eerdemgundogdu/acoustic-underwater-drone_swarm/hardware/output/acoustic-swarm-node-revA-bom.csv

Adet | Referanslar | Deger | Footprint | Parca | Not
2 | C1 C38 | 47uF 35V | CP_Elec_6.3x7.7 | Panasonic EEE-FK1V470P | H-koprusu VM toplu kapasite; Toplu giris kondansatoru
3 | C2 C3 C40 | 2.2uF 50V | C_1210_3225Metric | X7R 1210 50V
8 | C4 C12 C16 C18 C19 C32 C35 C41 | 100nF | C_0603_1608Metric | X7R 0603 16V
1 | C5 | 1uF 50V | C_1206_3216Metric | X7R 1206 50V
2 | C6 C9 | 4.7uF | C_0805_2012Metric | X5R 0805 10V
1 | C7 | 22uF 25V | C_1210_3225Metric | X5R 1210 25V
2 | C8 C39 | 100nF 50V | C_0603_1608Metric | X7R 0603 50V
5 | C11 C26 C27 C29 C34 | 10uF | C_0805_2012Metric | X5R 0805 10V
2 | C13 C28 | 100nF | C_1206_3216Metric | C0G/NP0 1206 50V
5 | C14 C15 C20 C24 C25 | 1uF | C_0603_1608Metric | X7R 0603 16V
1 | C17 | 470nF | C_0603_1608Metric | X7R 0603 16V
1 | C21 | 100nF 25V | C_0603_1608Metric | X7R 0603 25V
2 | C22 C23 | 22uF 10V | C_1206_3216Metric | X7R 1206 10V
3 | C30 C36 C37 | 2.2nF | C_0603_1608Metric | C0G 0603 50V
1 | C31 | 1nF | C_0603_1608Metric | C0G 0603 50V
1 | C33 | 270pF | C_0603_1608Metric | C0G 0603 50V
1 | D1 | SS26 | D_SMA | SS26 (60V 2A) | Ters kutup korumasi
1 | D2 | SMBJ20CA | D_SMB | Littelfuse SMBJ20CA | Vrwm 20V > 16.8V tam dolu; transdusor geri tepme kiskaci
1 | D3 | BZT52C3V3 | D_SOD-123 | BZT52C3V3 | ADC 3.3 V kiskaci
2 | D4 D6 | BAT54C | SOT-23 | BAT54C | Diyot-VEYA: yuksek olan kaynak AON alanini besler
1 | D5 | BAT54WS | D_SOD-323 | Diodes BAT54WS | Tepe (zarf) dedektoru
1 | D7 | SS16 | D_SMA | SS16 (60V 1A) | Buck serbest gecis (catch) diyodu
1 | D8 | YESIL | LED_0603_1608Metric | 0603 yesil LED | +5V var (dugum uyanik)
1 | D9 | B5819W | D_SOD-123 | B5819W (40V 1A) | USB 5V ile kart 5V birbirini geri beslemesin
5 | D10 D11 D12 D14 D15 | BAT54S | SOT-23 | BAT54S | Giris asiri gerilim kiskaci; Pin 16 (A2) kiskaci; Pin 17 (A3) kiskaci; Tam dalga kopru, 1. kol; Tam dalga kopru, 2. kol
1 | D13 | MAVI | LED_0603_1608Metric | 0603 mavi LED | Durum LED (pin 13, Teensy dahili LED ile paralel)
1 | D16 | BZT52C18 | D_SOD-123 | BZT52C18 | Depolama kiskaci: C7 25 V ve BAT54 30 V sinirlarinin altinda
1 | F1 | 2A 63V | Fuse_1206_3216Metric | Littelfuse 0466002.NRHF | Modem H-koprusu tepe akimi (ILIM 1 A) + lojik
1 | J1 | 4S LI-ION | TerminalBlock_Phoenix_MKDS-1,5-2-5.08_1x02_P5.08mm_Horizontal | Phoenix 1715721 | 4S Li-ion paket (BMS dahili), 12.0 - 16.8 V
1 | J2 | ARM-SW (NC) | JST_XH_B2B-XH-A_1x02_P2.50mm_Vertical | JST B2B-XH-A | Su gecirmez NC reed: tasima miknatisi takiliyken pil tamamen ayrik
1 | J3 | PIEZO | JST_XH_B2B-XH-A_1x02_P2.50mm_Vertical | JST B2B-XH-A | PVDF/PZT dalga-akinti hasat elemani (AC)
1 | J4 | HIDROFON | JST_XH_B3B-XH-A_1x03_P2.50mm_Vertical | JST B3B-XH-A | Pasif piezo hidrofon (-200 dB re 1V/uPa sinifi); pin 3 kablo ekrani
1 | J5 | TRANSDUSOR | JST_XH_B2B-XH-A_1x02_P2.50mm_Vertical | JST B2B-XH-A | Eslesme trafosu + 25 kHz rezonansli projektor (kart disi)
1 | J6 | SIZINTI PROBU | JST_XH_B2B-XH-A_1x02_P2.50mm_Vertical | JST B2B-XH-A | Tup ici iletken su sizinti elektrotlari
1 | L1 | 22uH | L_Bourns_SRN6045TA | Bourns SRN6045TA-220M | Isat >= 1 A
1 | Q1 | AO3401A | SOT-23 | AOS AO3401A | Vds -30V, Vgs +-12V
1 | Q2 | 2N7002 | SOT-23 | Nexperia 2N7002
4 | R1 R2 R4 R5 | 100k | R_0603_1608Metric | 0603 100k 1%
5 | R3 R35 R36 R37 R38 | 100 | R_0603_1608Metric | 0603 100 1%
1 | R6 | 15k | R_0603_1608Metric | 0603 15k 1%
5 | R7 R27 R30 R34 R42 | 1k | R_0603_1608Metric | 0603 1k 1%
6 | R8 R19 R22 R24 R25 R40 | 10k | R_0603_1608Metric | 0603 10k 1%
4 | R9 R10 R11 R28 | 10M | R_0603_1608Metric | 0603 10M 1%
4 | R12 R14 R20 R44 | 1M | R_0603_1608Metric | 0603 1M 1%
2 | R13 R15 | 33k | R_0603_1608Metric | 0603 33k 1%
2 | R16 R17 | 4.7M | R_0603_1608Metric | 0603 4.7M 1%
1 | R18 | 5.1M | R_0603_1608Metric | 0603 5.1M 1%
1 | R21 | 54.9k | R_0603_1608Metric | 0603 54.9k 1%
1 | R23 | 2.2k | R_0603_1608Metric | 0603 2.2k 1%
1 | R26 | 49.9 | R_0603_1608Metric | 0603 49.9 1%
2 | R29 R33 | 9.1k | R_0603_1608Metric | 0603 9.1k 1%
2 | R31 R32 | 2.7k | R_0603_1608Metric | 0603 2.7k 1%
1 | R39 | 62k | R_0603_1608Metric | 0603 62k 1%
1 | R41 | 47k | R_0603_1608Metric | 0603 47k 1%
1 | R43 | 330 | R_0603_1608Metric | 0603 330 1%
2 | U1 U2 | HT7533-1 | SOT-89-3 | Holtek HT7533-1 | Hasat LDO: Iq 2.5 uA, depolama > ~3.5 V iken regule; Vin max 30 V, Iq 2.5 uA, 100 mA
1 | U3 | MCP6042 | SOIC-8_3.9x4.9mm_P1.27mm | Microchip MCP6042-I/SN | GBW 14 kHz; kademe kazanci 31.3 -> BW ~450 Hz
1 | U4 | TLV7031 | SOT-23-5 | TI TLV7031DBVR | Push-pull, 335 nA
1 | U5 | LMR16006XDDCR | SOT-23-6 | TI LMR16006XDDCR | X versiyonu (700 kHz); sembol Y ile pin uyumlu
1 | U6 | LP5907MFX-3.3 | SOT-23-5 | TI LP5907MFX-3.3 | Dusuk gurultulu analog LDO
1 | U7 | Teensy 4.1 | Teensy4.1_Socket | PJRC Teensy 4.1 + 2x 1x24 disi header | Tum 3.3V pinleri bos; VIN D9 uzerinden
2 | U8 U9 | MCP6022 | SOIC-8_3.9x4.9mm_P1.27mm | Microchip MCP6022-I/SN | B kanali Vref tamponu; GBW 10 MHz, 8.7 nV/rtHz, RRIO
1 | U10 | DRV8871 | Texas_HTSOP-8-1EP_3.9x4.9mm_P1.27mm_EP2.95x4.9mm_Mask2.4x3.1mm_ThermalVias | TI DRV8871DDAR | PWM <= 200 kHz; IN1=IN2=0 iken ~1 ms sonra uyku (<1 uA)
