eerdemgundogdu/acoustic-underwater-drone_swarm/hardware/output/acoustic-swarm-node-revA-schematic.pdf

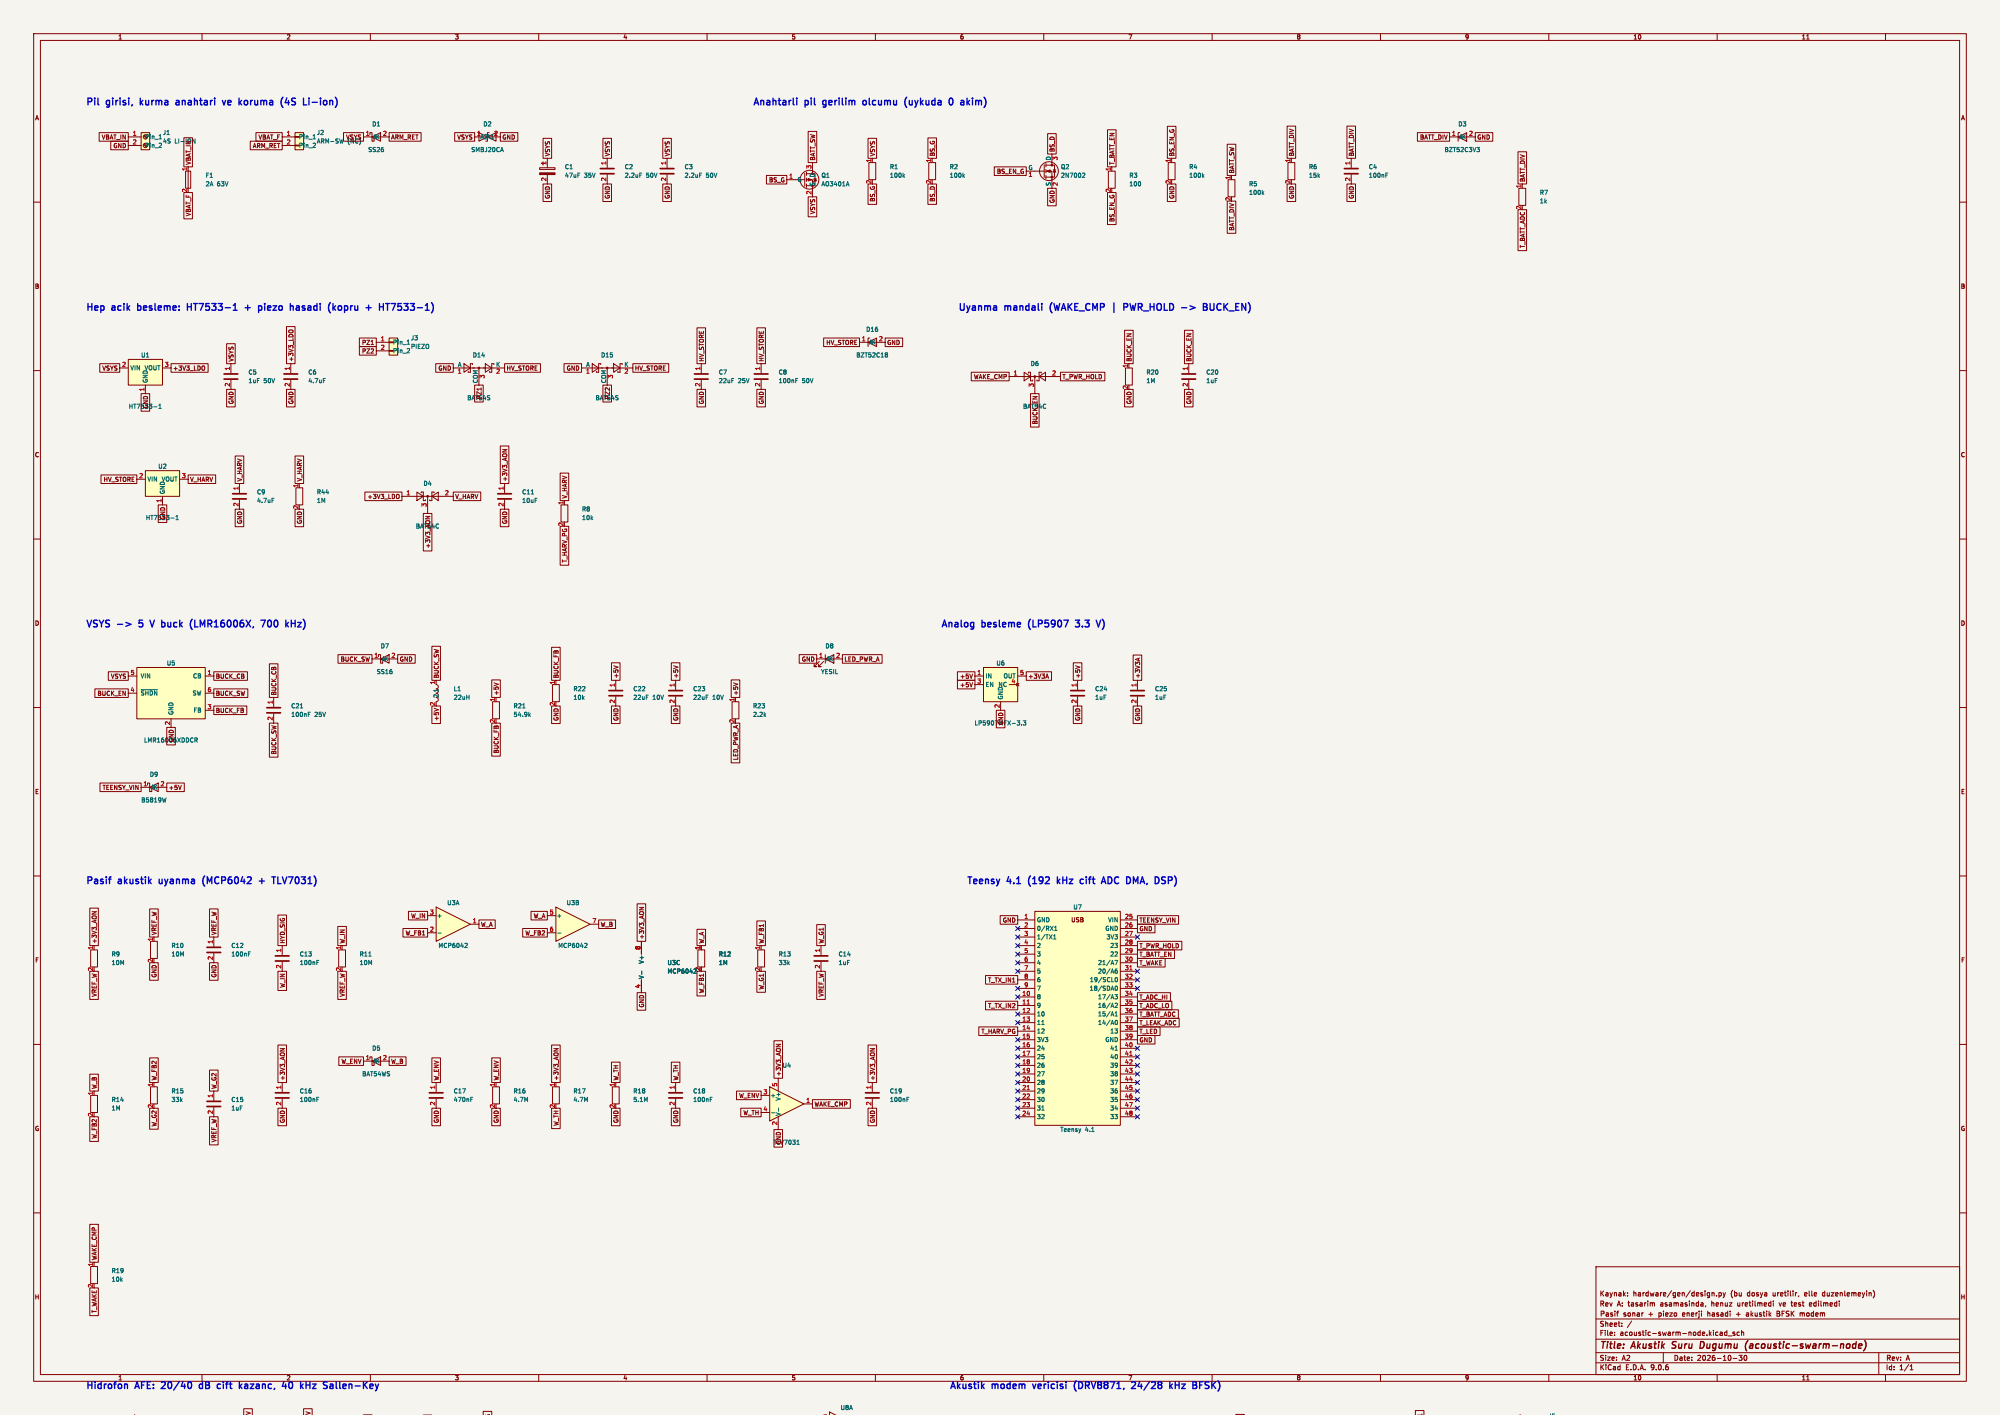
[picture p4: page 1]

1 PWR_FLAG GND BATT_SW BATT_DIV GND BATT_DIV BATT_DIV GND BUCK_EN GND BUCK_EN GND BS_G BS_D
