eerdemgundogdu/acoustic-underwater-drone_swarm/hardware/acoustic-swarm-node/acoustic-swarm-node.kicad_pcb

## KiCad design hardware/acoustic-swarm-node/acoustic-swarm-node.kicad_pcb (2026-10-30)

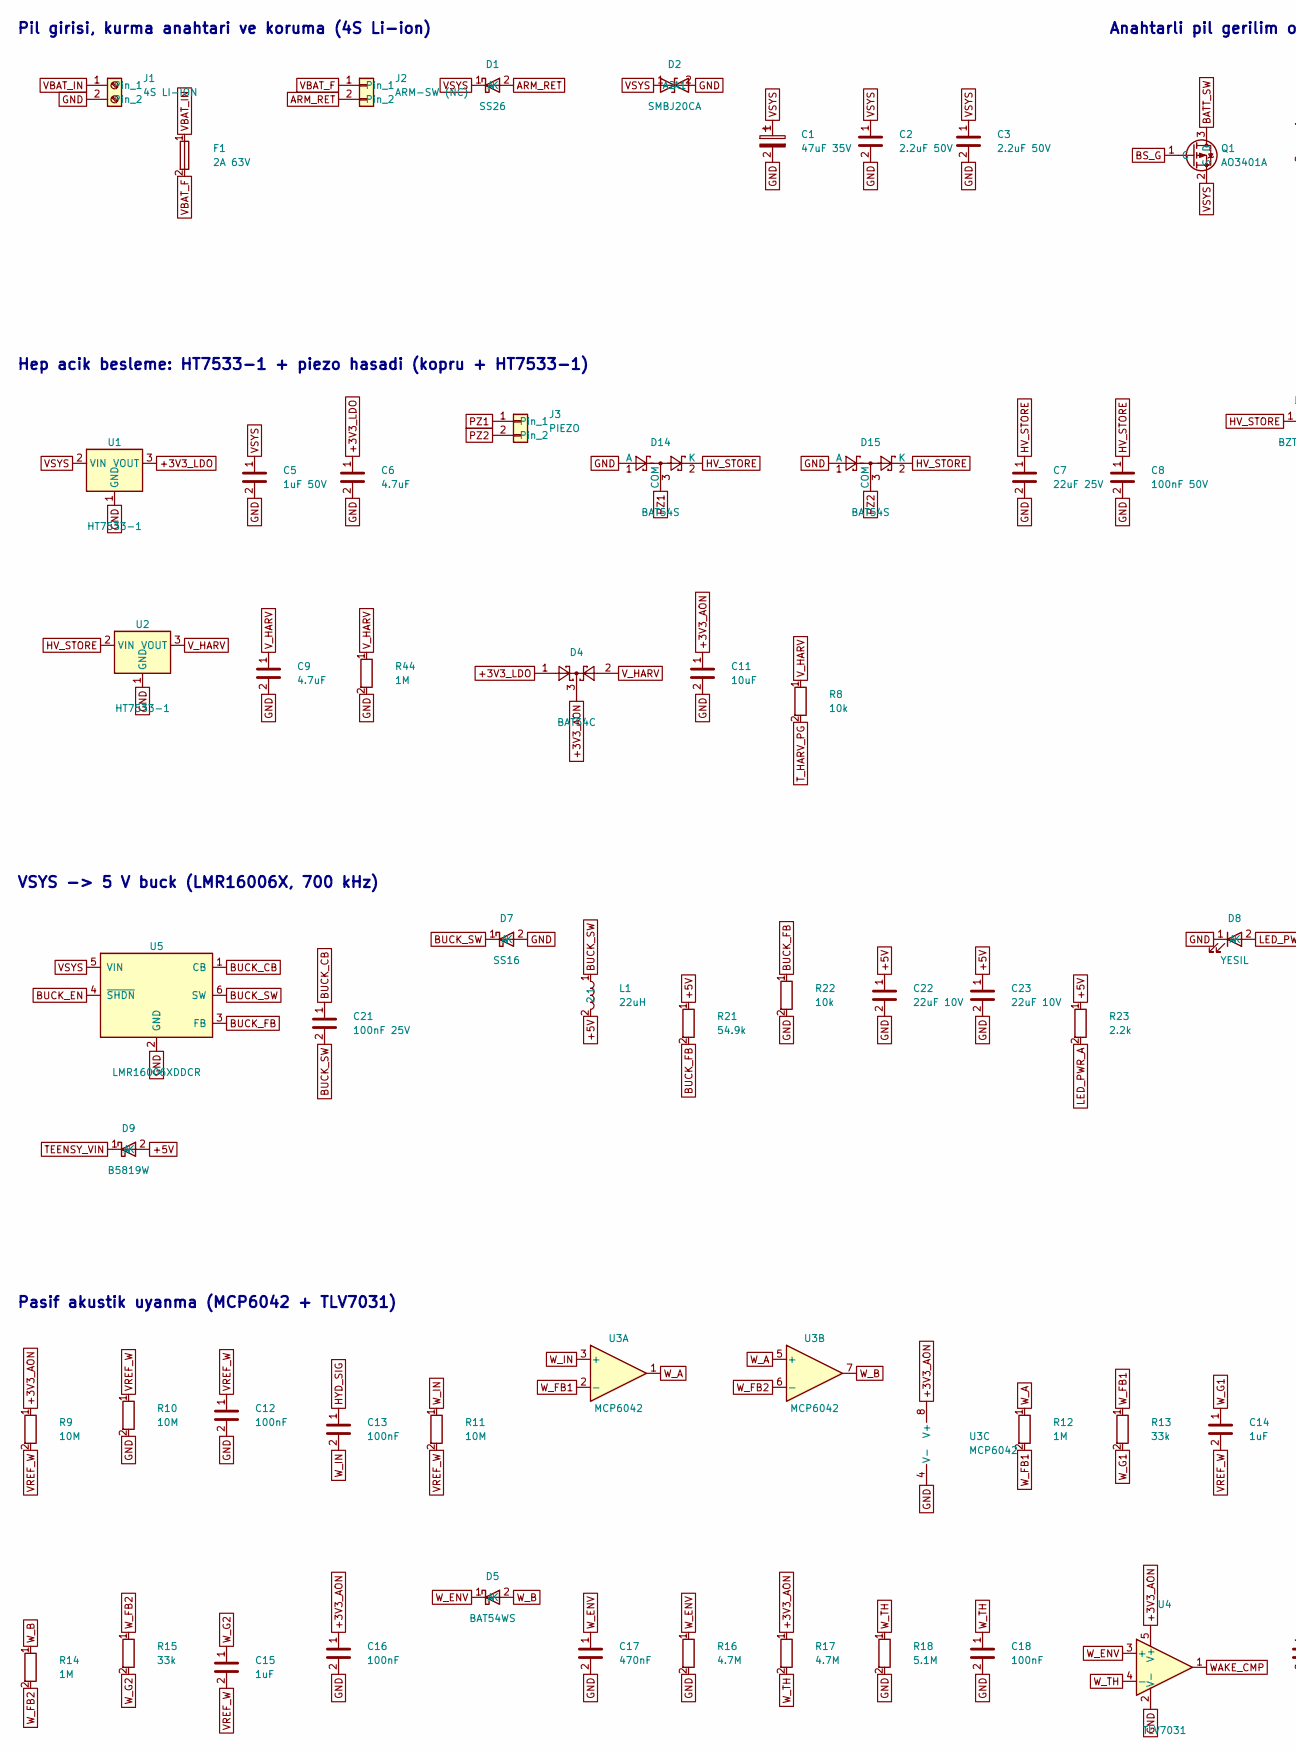
[picture p5: schematic acoustic-swarm-node.kicad_sch, Akustik Suru Dugumu (acoustic-swarm-node), part in row 1, column 1]

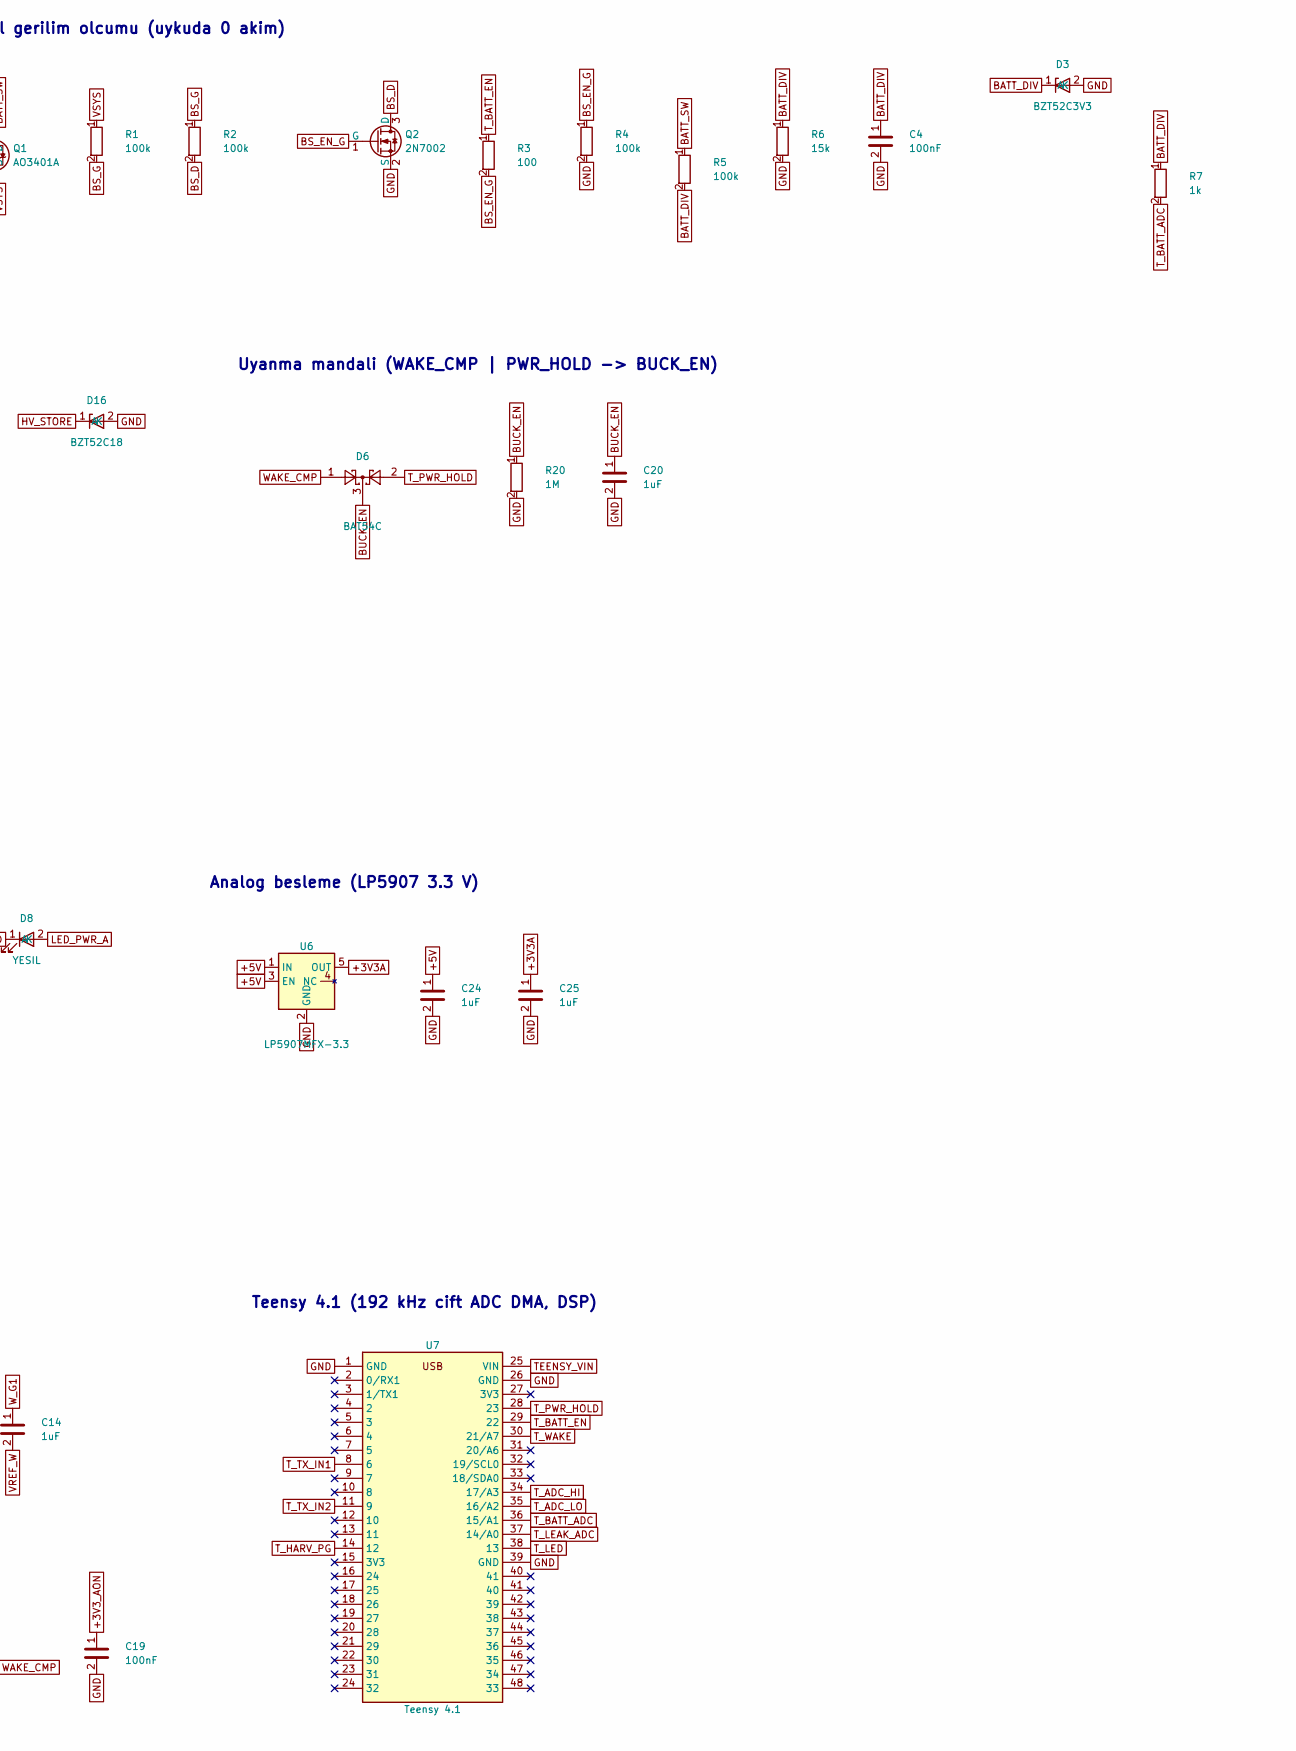
[picture p6: schematic acoustic-swarm-node.kicad_sch, Akustik Suru Dugumu (acoustic-swarm-node), part in row 1, column 2]

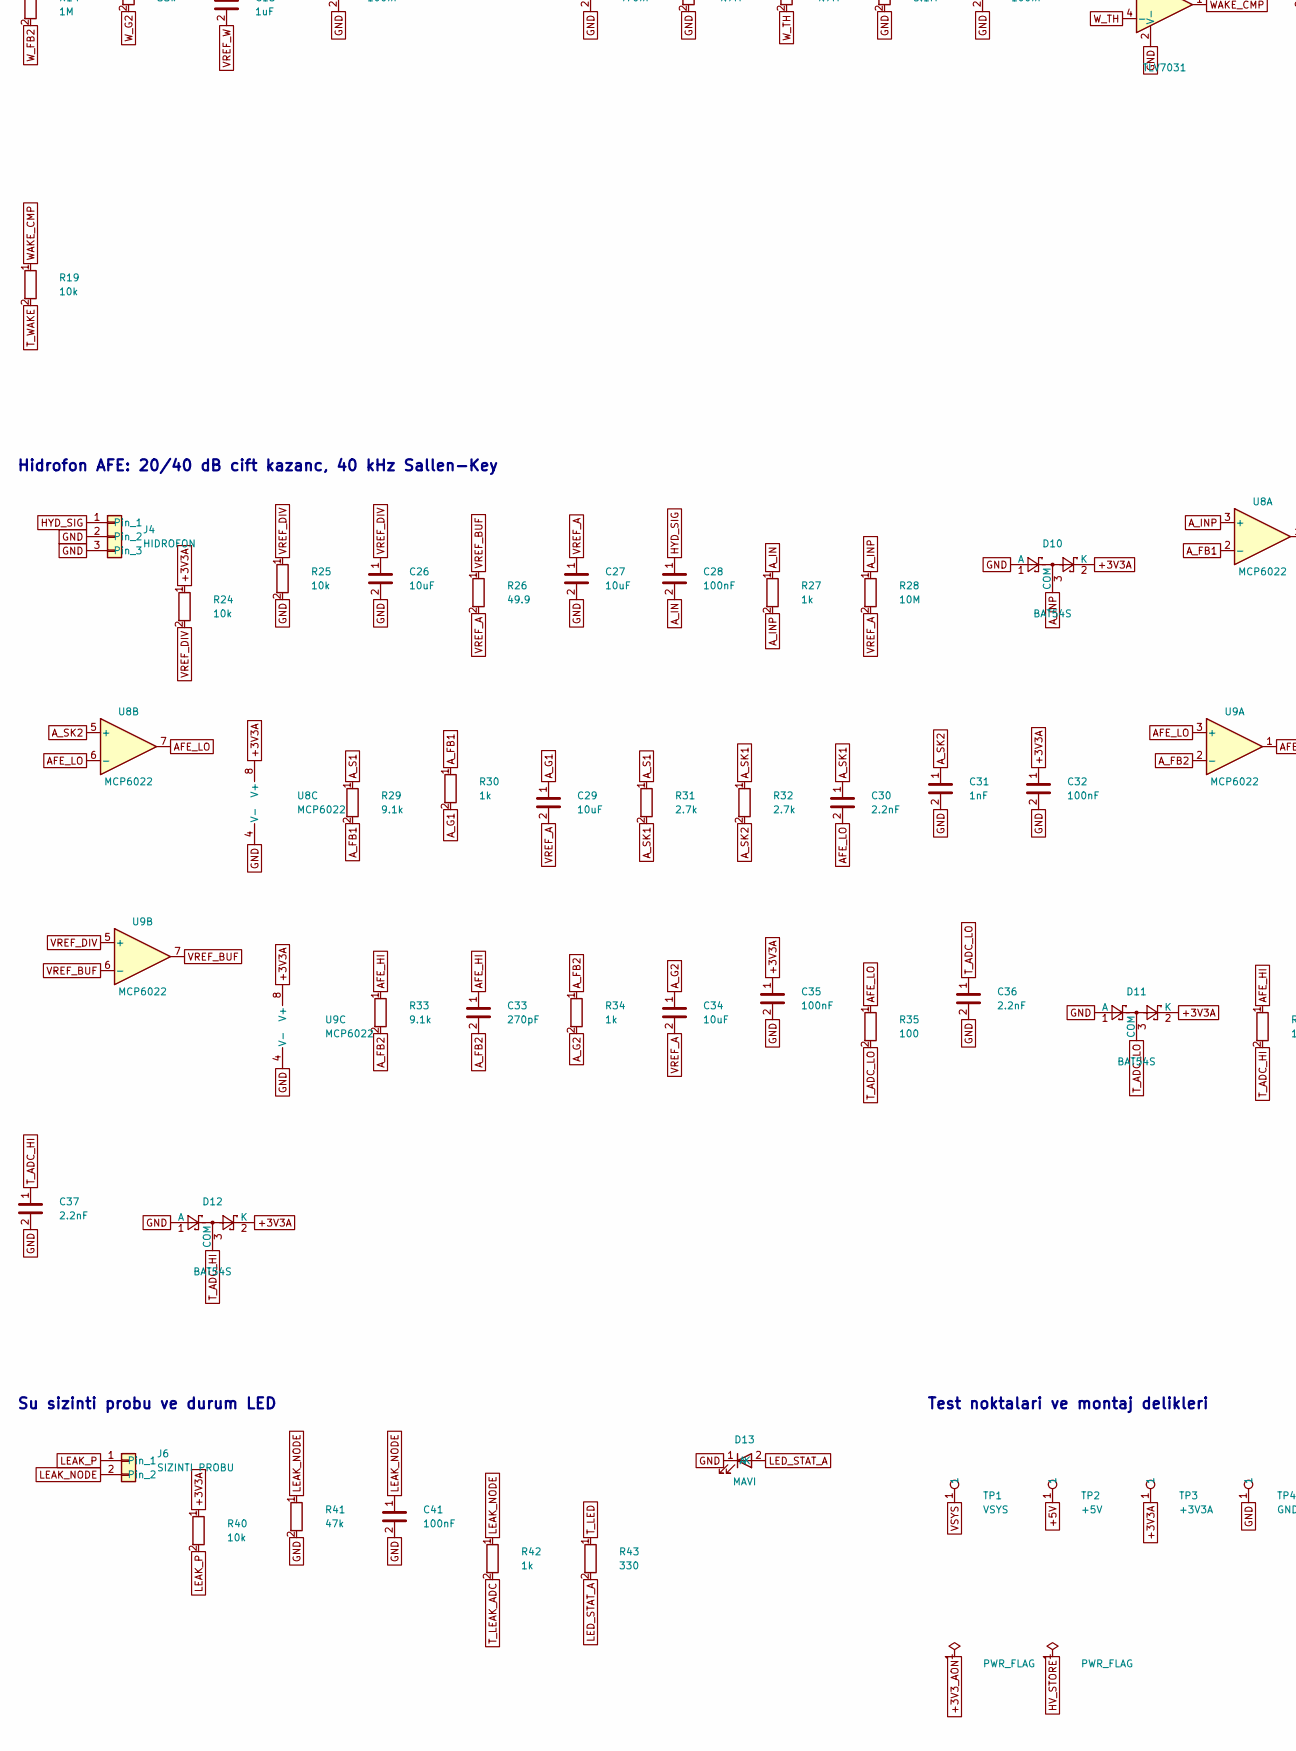
[picture p7: schematic acoustic-swarm-node.kicad_sch, Akustik Suru Dugumu (acoustic-swarm-node), part in row 2, column 1]

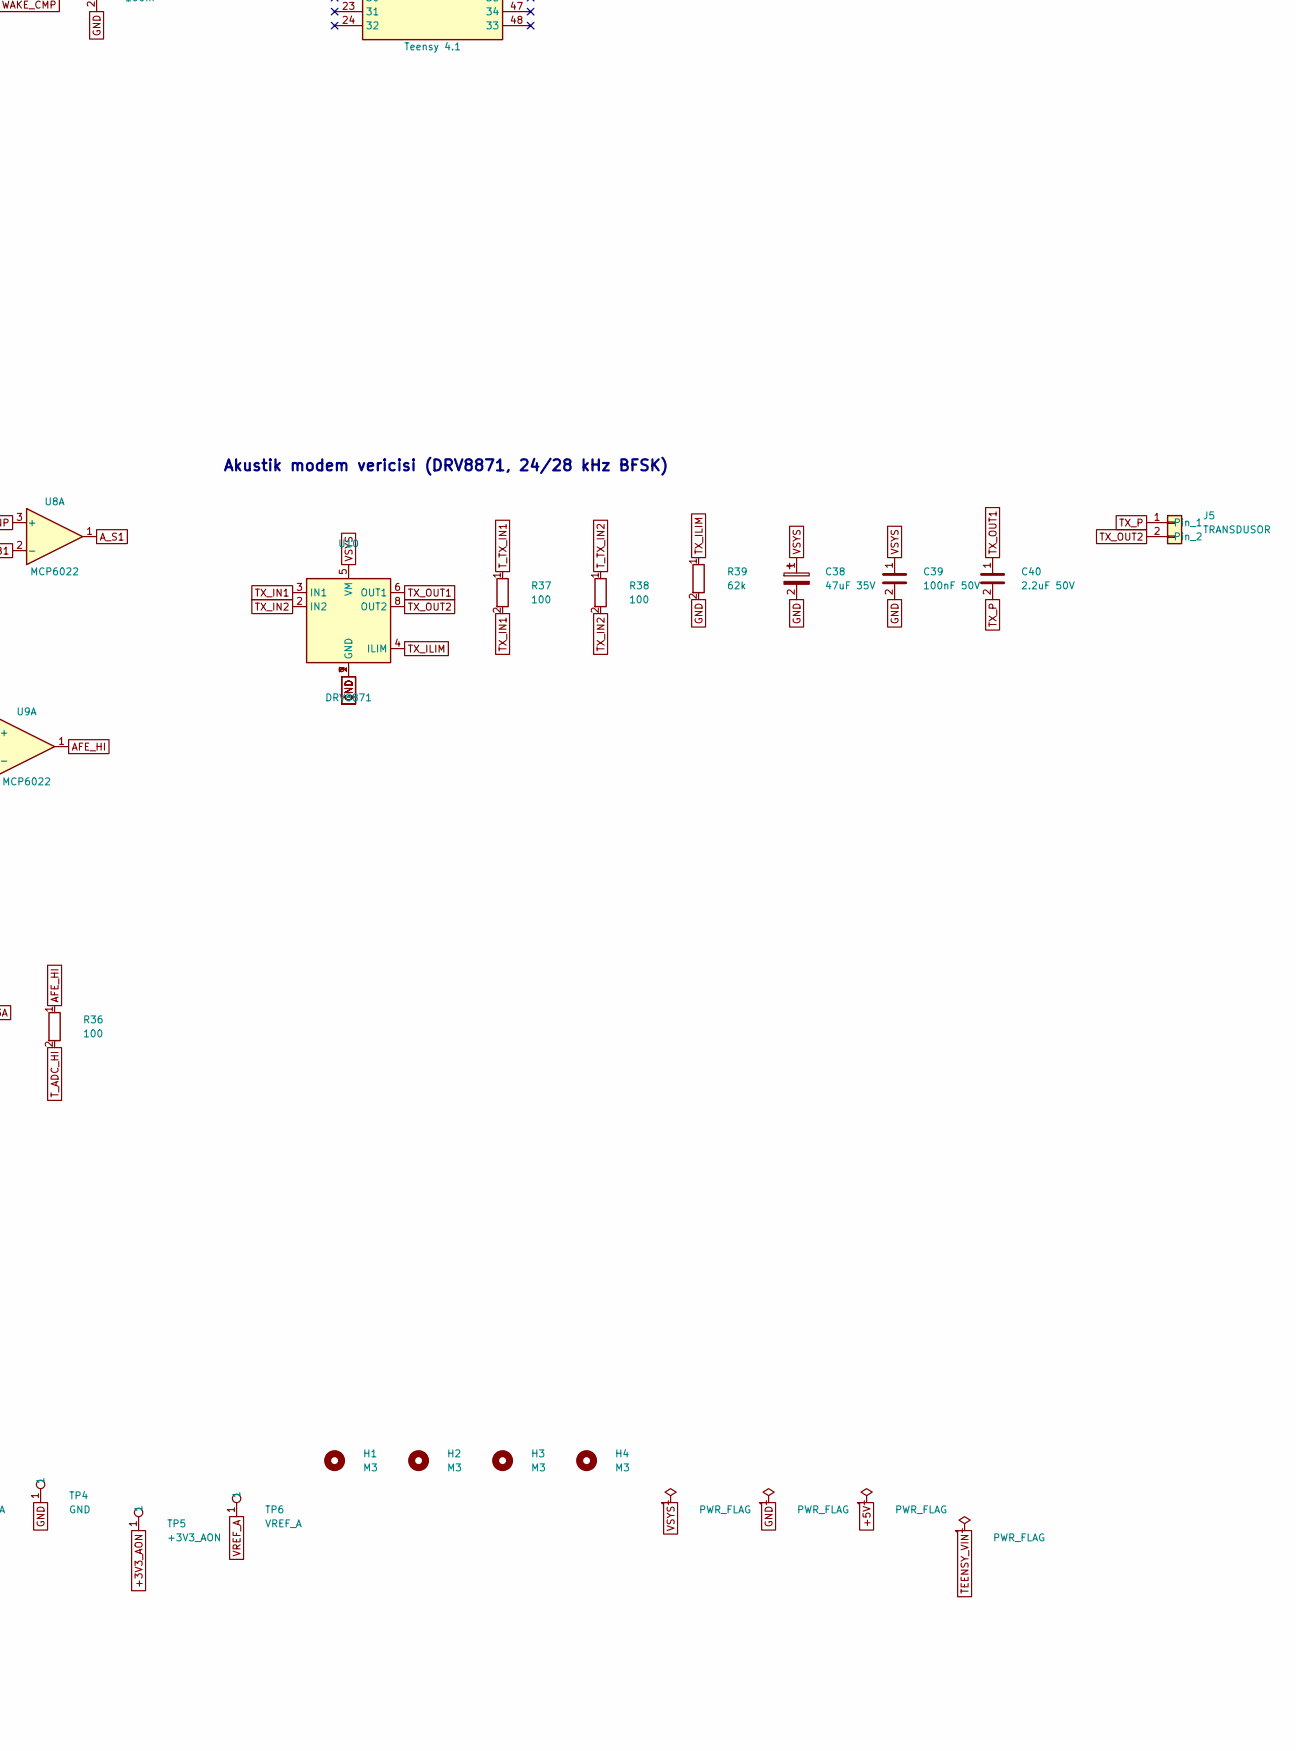
[picture p8: schematic acoustic-swarm-node.kicad_sch, Akustik Suru Dugumu (acoustic-swarm-node), part in row 2, column 2]

Parts:
C1, C38: 47uF 35V; CP_Elec_6.3x7.7; MPN Panasonic EEE-FK1V470P
C2, C3, C40: 2.2uF 50V; C_1210_3225Metric; MPN X7R 1210 50V
C4, C12, C16, C18, C19, C32, C35, C41: 100nF; C_0603_1608Metric; MPN X7R 0603 16V
C5: 1uF 50V; C_1206_3216Metric; MPN X7R 1206 50V
C6, C9: 4.7uF; C_0805_2012Metric; MPN X5R 0805 10V
C7: 22uF 25V; C_1210_3225Metric; MPN X5R 1210 25V
C8, C39: 100nF 50V; C_0603_1608Metric; MPN X7R 0603 50V
C11, C26, C27, C29, C34: 10uF; C_0805_2012Metric; MPN X5R 0805 10V
C13, C28: 100nF; C_1206_3216Metric; MPN C0G/NP0 1206 50V
C14, C15, C20, C24, C25: 1uF; C_0603_1608Metric; MPN X7R 0603 16V
C17: 470nF; C_0603_1608Metric; MPN X7R 0603 16V
C21: 100nF 25V; C_0603_1608Metric; MPN X7R 0603 25V
C22, C23: 22uF 10V; C_1206_3216Metric; MPN X7R 1206 10V
C30, C36, C37: 2.2nF; C_0603_1608Metric; MPN C0G 0603 50V
C31: 1nF; C_0603_1608Metric; MPN C0G 0603 50V
C33: 270pF; C_0603_1608Metric; MPN C0G 0603 50V
D1: SS26; D_SMA; MPN SS26 (60V 2A)
D2: SMBJ20CA; D_SMB; MPN Littelfuse SMBJ20CA
D3: BZT52C3V3; D_SOD-123; MPN BZT52C3V3
D4, D6: BAT54C; SOT-23; MPN BAT54C
D5: BAT54WS; D_SOD-323; MPN Diodes BAT54WS
D7: SS16; D_SMA; MPN SS16 (60V 1A)
D8: YESIL; LED_0603_1608Metric; MPN 0603 yesil LED
D9: B5819W; D_SOD-123; MPN B5819W (40V 1A)
D10, D11, D12, D14, D15: BAT54S; SOT-23; MPN BAT54S
D13: MAVI; LED_0603_1608Metric; MPN 0603 mavi LED
D16: BZT52C18; D_SOD-123; MPN BZT52C18
F1: 2A 63V; Fuse_1206_3216Metric; MPN Littelfuse 0466002.NRHF
H1, H2, H3, H4: M3; MountingHole_3.2mm_M3
J1: 4S LI-ION; TerminalBlock_Phoenix_MKDS-1,5-2-5.08_1x02_P5.08mm_Horizont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; MPN Phoenix 1715721
J2: ARM-SW (NC); JST_XH_B2B-XH-A_1x02_P2.50mm_Vertical; MPN JST B2B-XH-A
J3: PIEZO; JST_XH_B2B-XH-A_1x02_P2.50mm_Vertical; MPN JST B2B-XH-A
J4: HIDROFON; JST_XH_B3B-XH-A_1x03_P2.50mm_Vertical; MPN JST B3B-XH-A
J5: TRANSDUSOR; JST_XH_B2B-XH-A_1x02_P2.50mm_Vertical; MPN JST B2B-XH-A
J6: SIZINTI PROBU; JST_XH_B2B-XH-A_1x02_P2.50mm_Vertical; MPN JST B2B-XH-A
L1: 22uH; L_Bourns_SRN6045TA; MPN Bourns SRN6045TA-220M
Q1: AO3401A; SOT-23; MPN AOS AO3401A
Q2: 2N7002; SOT-23; MPN Nexperia 2N7002
R1, R2, R4, R5: 100k; R_0603_1608Metric; MPN 0603 100k 1%
R3, R35, R36, R37, R38: 100; R_0603_1608Metric; MPN 0603 100 1%
R6: 15k; R_0603_1608Metric; MPN 0603 15k 1%
R7, R27, R30, R34, R42: 1k; R_0603_1608Metric; MPN 0603 1k 1%
R8, R19, R22, R24, R25, R40: 10k; R_0603_1608Metric; MPN 0603 10k 1%
R9, R10, R11, R28: 10M; R_0603_1608Metric; MPN 0603 10M 1%
R12, R14, R20, R44: 1M; R_0603_1608Metric; MPN 0603 1M 1%
R13, R15: 33k; R_0603_1608Metric; MPN 0603 33k 1%
R16, R17: 4.7M; R_0603_1608Metric; MPN 0603 4.7M 1%
R18: 5.1M; R_0603_1608Metric; MPN 0603 5.1M 1%
R21: 54.9k; R_0603_1608Metric; MPN 0603 54.9k 1%
R23: 2.2k; R_0603_1608Metric; MPN 0603 2.2k 1%
R26: 49.9; R_0603_1608Metric; MPN 0603 49.9 1%
R29, R33: 9.1k; R_0603_1608Metric; MPN 0603 9.1k 1%
R31, R32: 2.7k; R_0603_1608Metric; MPN 0603 2.7k 1%
R39: 62k; R_0603_1608Metric; MPN 0603 62k 1%
R41: 47k; R_0603_1608Metric; MPN 0603 47k 1%
R43: 330; R_0603_1608Metric; MPN 0603 330 1%
TP1: VSYS; TestPoint_Pad_D1.5mm
TP2: +5V; TestPoint_Pad_D1.5mm
TP3: +3V3A; TestPoint_Pad_D1.5mm
TP4: GND; TestPoint_Pad_D1.5mm
TP5: +3V3_AON; TestPoint_Pad_D1.5mm
TP6: VREF_A; TestPoint_Pad_D1.5mm
U1, U2: HT7533-1; SOT-89-3; MPN Holtek HT7533-1
U3: MCP6042; SOIC-8_3.9x4.9mm_P1.27mm; MPN Microchip MCP6042-I/SN
U4: TLV7031; SOT-23-5; MPN TI TLV7031DBVR
U5: LMR16006XDDCR; SOT-23-6; MPN TI LMR16006XDDCR
U6: LP5907MFX-3.3; SOT-23-5; MPN TI LP5907MFX-3.3
U7: Teensy 4.1; Teensy4.1_Socket; MPN PJRC Teensy 4.1 + 2x 1x24 disi header
U8, U9: MCP6022; SOIC-8_3.9x4.9mm_P1.27mm; MPN Microchip MCP6022-I/SN
U10: DRV8871; Texas_HTSOP-8-1EP_3.9x4.9mm_P1.27mm_EP2.95x4.9mm_Mask2.4x3.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; MPN TI DRV8871DDAR

Connections:
+3V3A: C25.1, C32.1, C35.1, D10.2 (K), D11.2 (K), D12.2 (K), R24.1, R40.1, TP3.1, U6.5 (OUT), U8.8 (V+), U9.8 (V+)
+3V3_AON: C11.1, C16.1, C19.1, D4.3, R9.1, R17.1, TP5.1, U3.8 (V+), U4.5 (V+)
+3V3_LDO: C6.1, D4.1, U1.3 (VOUT)
+5V: C22.1, C23.1, C24.1, D9.2 (A), L1.2, R21.1, R23.1, TP2.1, U6.1 (IN), U6.3 (EN)
AFE_HI: C33.1, R33.1, R36.1, U9.1
AFE_LO: C30.2, R35.1, U8.6 (-), U8.7, U9.3 (+)
ARM_RET: D1.2 (A), J2.2
A_FB1: R29.2, R30.1, U8.2 (-)
A_FB2: C33.2, R33.2, R34.1, U9.2 (-)
A_G1: C29.1, R30.2
A_G2: C34.1, R34.2
A_IN: C28.2, R27.1
A_INP: D10.3 (COM), R27.2, R28.1, U8.3 (+)
A_S1: R29.1, R31.1, U8.1
A_SK1: C30.1, R31.2, R32.1
A_SK2: C31.1, R32.2, U8.5 (+)
BATT_DIV: C4.1, D3.1 (K), R5.2, R6.1, R7.1
BATT_SW: Q1.3 (D), R5.1
BS_D: Q2.3 (D), R2.2
BS_EN_G: Q2.1 (G), R3.2, R4.1
BS_G: Q1.1 (G), R1.2, R2.1
BUCK_CB: C21.1, U5.1 (CB)
BUCK_EN: C20.1, D6.3, R20.1, U5.4 (~SHDN)
BUCK_FB: R21.2, R22.1, U5.3 (FB)
BUCK_SW: C21.2, D7.1 (K), L1.1, U5.6 (SW)
GND: C1.2, C2.2, C3.2, C4.2, C5.2, C6.2, C7.2, C8.2, C9.2, C11.2, C12.2, C16.2, C17.2, C18.2, C19.2, C20.2, C22.2, C23.2, C24.2, C25.2, C26.2, C27.2, C31.2, C32.2, C35.2, C36.2, C37.2, C38.2, C39.2, C41.2, D2.2 (A2), D3.2 (A), D7.2 (A), D8.1 (K), D10.1 (A), D11.1 (A), D12.1 (A), D13.1 (K), D14.1 (A), D15.1 (A), D16.2 (A), J1.2, J4.2, J4.3, Q2.2 (S), R4.2, R6.2, R10.2, R16.2, R18.2, R20.2, R22.2, R25.2, R39.2, R41.2, R44.2, TP4.1, U1.1 (GND), U2.1 (GND), U3.4 (V-), U4.2 (V-), U5.2 (GND), U6.2 (GND), U7.1 (GND), U7.26 (GND), U7.39 (GND), U8.4 (V-), U9.4 (V-), U10.1 (GND), U10.7 (GND), U10.9 (GND)
HV_STORE: C7.1, C8.1, D14.2 (K), D15.2 (K), D16.1 (K), U2.2 (VIN)
HYD_SIG: C13.1, C28.1, J4.1
LEAK_NODE: C41.1, J6.2, R41.1, R42.1
LEAK_P: J6.1, R40.2
LED_PWR_A: D8.2 (A), R23.2
LED_STAT_A: D13.2 (A), R43.2
PZ1: D14.3 (COM), J3.1
PZ2: D15.3 (COM), J3.2
TEENSY_VIN: D9.1 (K), U7.25 (VIN)
TX_ILIM: R39.1, U10.4 (ILIM)
TX_IN1: R37.2, U10.3 (IN1)
TX_IN2: R38.2, U10.2 (IN2)
TX_OUT1: C40.1, U10.6 (OUT1)
TX_OUT2: J5.2, U10.8 (OUT2)
TX_P: C40.2, J5.1
T_ADC_HI: C37.1, D12.3 (COM), R36.2, U7.34 (17/A3)
T_ADC_LO: C36.1, D11.3 (COM), R35.2, U7.35 (16/A2)
T_BATT_ADC: R7.2, U7.36 (15/A1)
T_BATT_EN: R3.1, U7.29 (22)
T_HARV_PG: R8.2, U7.14 (12)
T_LEAK_ADC: R42.2, U7.37 (14/A0)
T_LED: R43.1, U7.38 (13)
T_PWR_HOLD: D6.2, U7.28 (23)
T_TX_IN1: R37.1, U7.8 (6)
T_TX_IN2: R38.1, U7.11 (9)
T_WAKE: R19.2, U7.30 (21/A7)
VBAT_F: F1.2, J2.1
VBAT_IN: F1.1, J1.1
VREF_A: C27.1, C29.2, C34.2, R26.2, R28.2, TP6.1
VREF_BUF: R26.1, U9.6 (-), U9.7
VREF_DIV: C26.1, R24.2, R25.1, U9.5 (+)
VREF_W: C12.1, C14.2, C15.2, R9.2, R10.1, R11.2
VSYS: C1.1, C2.1, C3.1, C5.1, C38.1, C39.1, D1.1 (K), D2.1 (A1), Q1.2 (S), R1.1, TP1.1, U1.2 (VIN), U5.5 (VIN), U10.5 (VM)
V_HARV: C9.1, D4.2, R8.1, R44.1, U2.3 (VOUT)
WAKE_CMP: D6.1, R19.1, U4.1
W_A: R12.1, U3.1, U3.5 (+)
W_B: D5.2 (A), R14.1, U3.7
W_ENV: C17.1, D5.1 (K), R16.1, U4.3 (+)
W_FB1: R12.2, R13.1, U3.2 (-)
W_FB2: R14.2, R15.1, U3.6 (-)
W_G1: C14.1, R13.2
W_G2: C15.1, R15.2
W_IN: C13.2, R11.1, U3.3 (+)
W_TH: C18.1, R17.2, R18.1, U4.4 (-)

Notes on the sheet:
Pil girisi, kurma anahtari ve koruma (4S Li-ion)
Anahtarli pil gerilim olcumu (uykuda 0 akim)
Hep acik besleme: HT7533-1 + piezo hasadi (kopru + HT7533-1)
Uyanma mandali (WAKE_CMP | PWR_HOLD -> BUCK_EN)
VSYS -> 5 V buck (LMR16006X, 700 kHz)
Analog besleme (LP5907 3.3 V)
Pasif akustik uyanma (MCP6042 + TLV7031)
Teensy 4.1 (192 kHz cift ADC DMA, DSP)
Hidrofon AFE: 20/40 dB cift kazanc, 40 kHz Sallen-Key
Akustik modem vericisi (DRV8871, 24/28 kHz BFSK)
Su sizinti probu ve durum LED
Test noktalari ve montaj delikleri

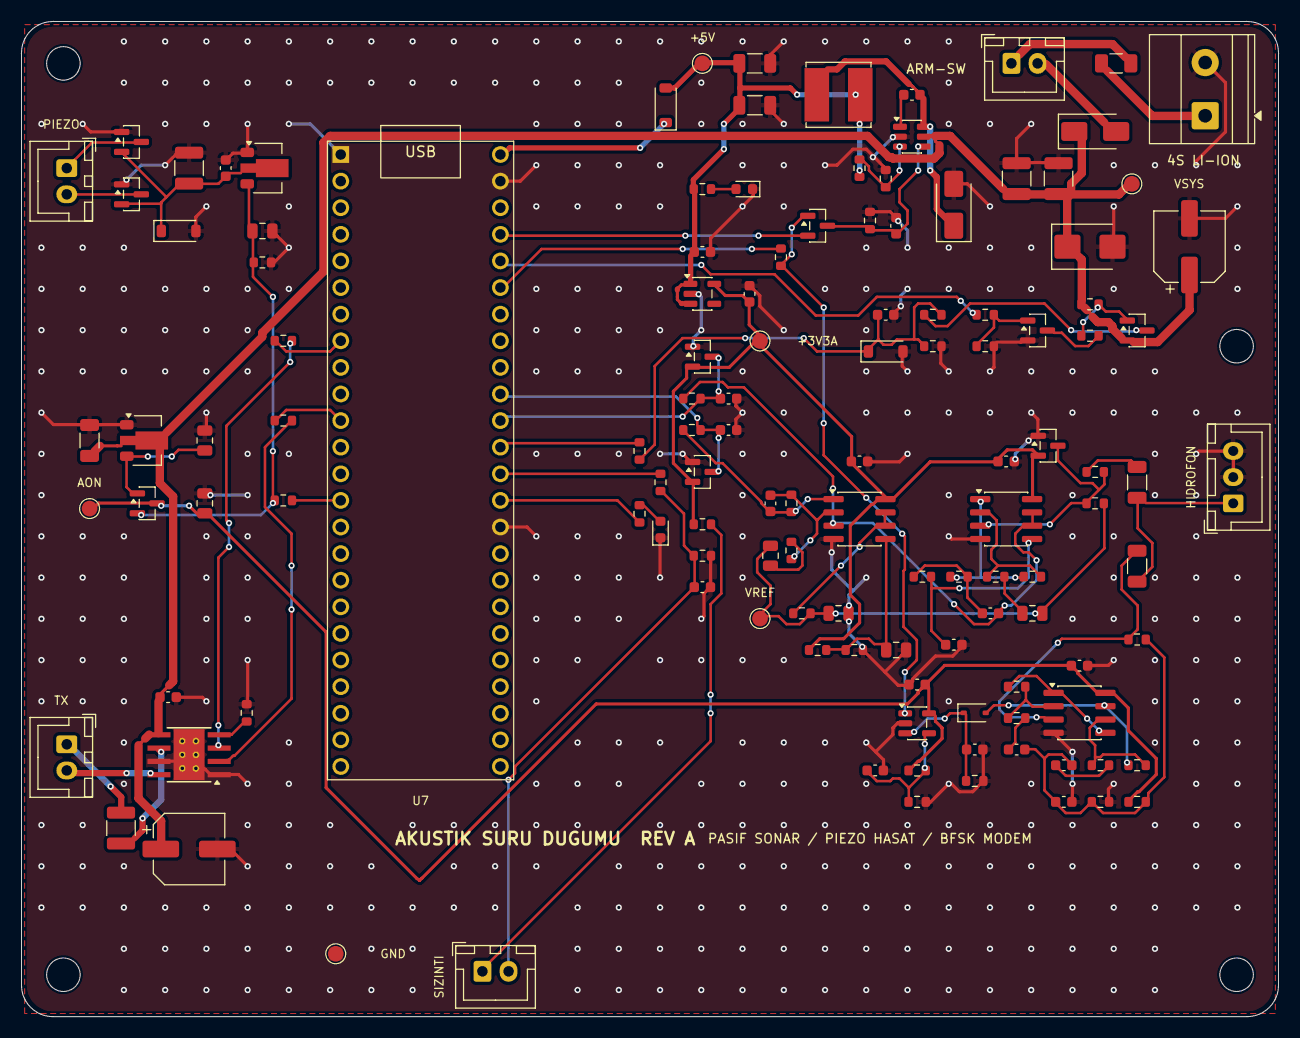
[picture p9: board acoustic-swarm-node.kicad_pcb from above]

Board: 2 copper layers, 120.0 x 95.0 mm, 130 parts (0 on the bottom side), 70 nets.
