eerdemgundogdu/acoustic-underwater-drone_swarm/hardware/pelagos-node-carrier/pelagos-node-carrier.kicad_pcb

## KiCad design hardware/pelagos-node-carrier/pelagos-node-carrier.kicad_pcb (2026-10-29)

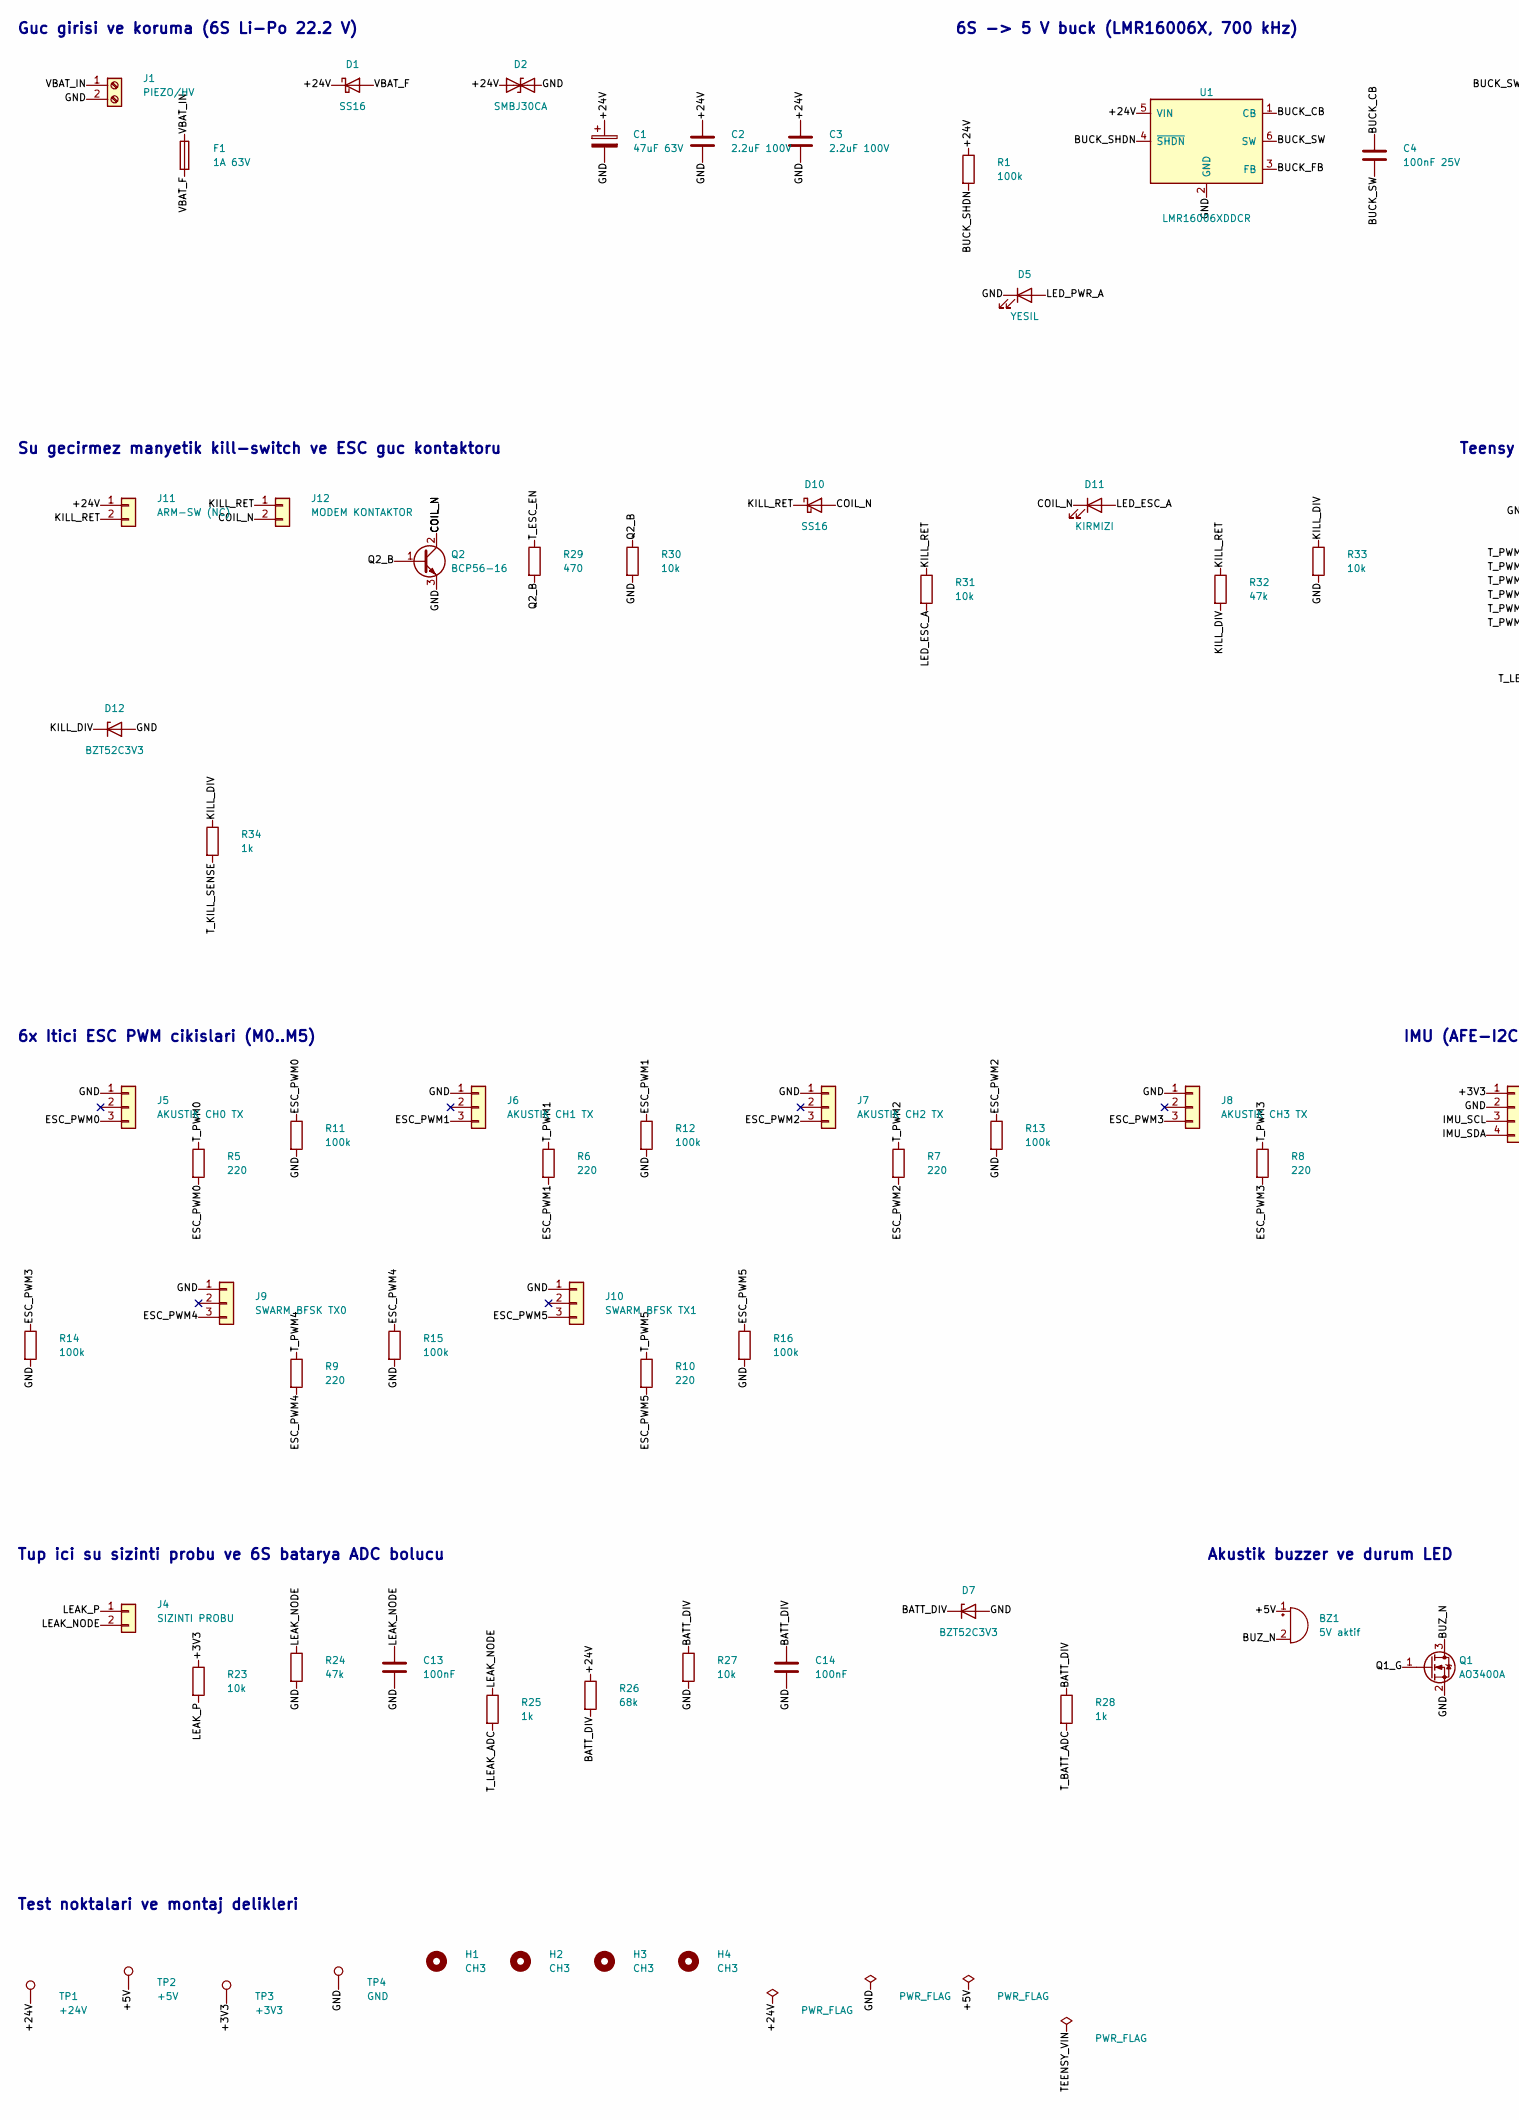
[picture p10: schematic pelagos-node-carrier.kicad_sch, Pelagos Deniz Tabani Akustik Dugum Karti, part in row 1, column 1]

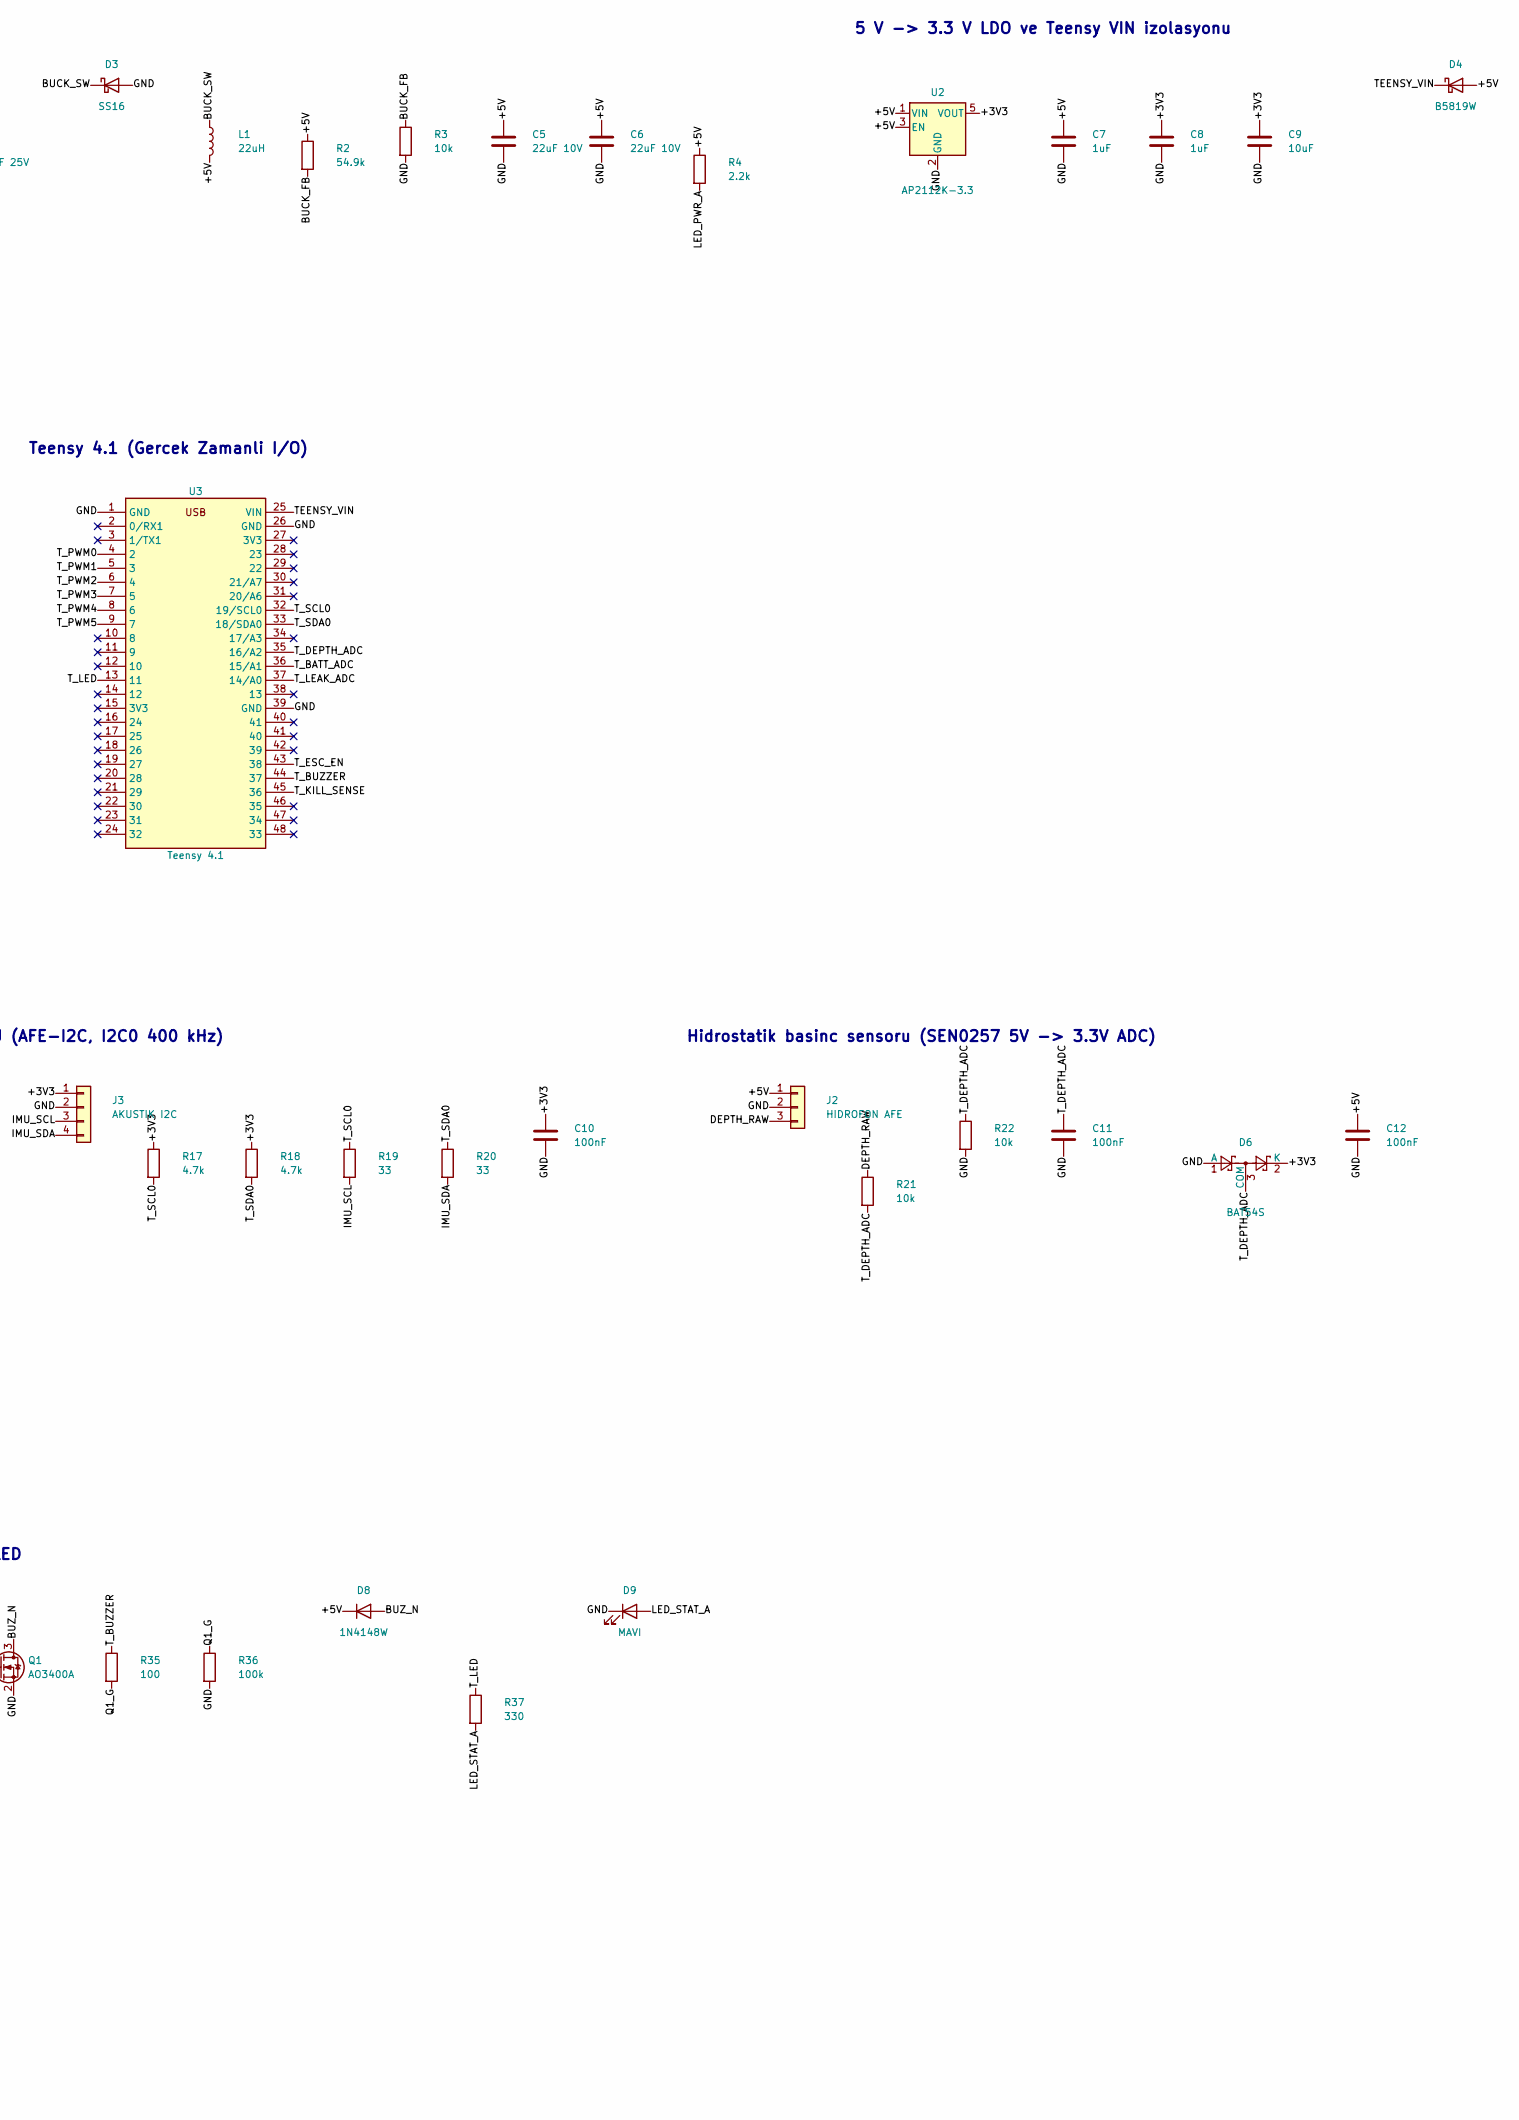
[picture p11: schematic pelagos-node-carrier.kicad_sch, Pelagos Deniz Tabani Akustik Dugum Karti, part in row 1, column 2]

Parts:
BZ1: 5V aktif; Buzzer_12x9.5RM7.6; MPN 12 mm 5V aktif buzzer
C1: 47uF 63V; CP_Elec_8x10; MPN Panasonic EEE-FK1J470P
C2, C3: 2.2uF 100V; C_1210_3225Metric; MPN X7R 1210 100V
C4: 100nF 25V; C_0603_1608Metric; MPN X7R 0603 25V
C5, C6: 22uF 10V; C_1206_3216Metric; MPN X7R 1206 10V
C7, C8: 1uF; C_0603_1608Metric; MPN X7R 0603 16V
C9: 10uF; C_0805_2012Metric; MPN X5R 0805 10V
C10, C11, C12, C13, C14: 100nF; C_0603_1608Metric; MPN X7R 0603 16V
D1, D3, D10: SS16; D_SMA; MPN SS16 (60V 1A)
D2: SMBJ30CA; D_SMB; MPN Littelfuse SMBJ30CA
D4: B5819W; D_SOD-123; MPN B5819W (40V 1A)
D5: YESIL; LED_0603_1608Metric; MPN 0603 yesil LED
D6: BAT54S; SOT-23; MPN BAT54S
D7, D12: BZT52C3V3; D_SOD-123; MPN BZT52C3V3
D8: 1N4148W; D_SOD-323; MPN 1N4148WS
D9: MAVI; LED_0603_1608Metric; MPN 0603 mavi LED
D11: KIRMIZI; LED_0603_1608Metric; MPN 0603 kirmizi LED
F1: 1A 63V; Fuse_1206_3216Metric; MPN Littelfuse 0466001.NRHF
H1, H2, H3, H4: CH3; MountingHole_3.2mm_M3
J1: PIEZO/HV; TerminalBlock_Phoenix_MKDS-1,5-2-5.08_1x02_P5.08mm_Horizont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; MPN Phoenix 1715721
J2: HIDROFON AFE; JST_XH_B3B-XH-A_1x03_P2.50mm_Vertical; MPN JST B3B-XH-A
J3: AKUSTIK I2C; JST_XH_B4B-XH-A_1x04_P2.50mm_Vertical; MPN JST B4B-XH-A
J4: SIZINTI PROBU; JST_XH_B2B-XH-A_1x02_P2.50mm_Vertical; MPN JST B2B-XH-A
J5: AKUSTIK CH0 TX; JST_XH_B3B-XH-A_1x03_P2.50mm_Vertical; MPN JST B3B-XH-A
J6: AKUSTIK CH1 TX; JST_XH_B3B-XH-A_1x03_P2.50mm_Vertical; MPN JST B3B-XH-A
J7: AKUSTIK CH2 TX; JST_XH_B3B-XH-A_1x03_P2.50mm_Vertical; MPN JST B3B-XH-A
J8: AKUSTIK CH3 TX; JST_XH_B3B-XH-A_1x03_P2.50mm_Vertical; MPN JST B3B-XH-A
J9: SWARM BFSK TX0; JST_XH_B3B-XH-A_1x03_P2.50mm_Vertical; MPN JST B3B-XH-A
J10: SWARM BFSK TX1; JST_XH_B3B-XH-A_1x03_P2.50mm_Vertical; MPN JST B3B-XH-A
J11: ARM-SW (NC); JST_XH_B2B-XH-A_1x02_P2.50mm_Vertical; MPN JST B2B-XH-A
J12: MODEM KONTAKTOR; JST_XH_B2B-XH-A_1x02_P2.50mm_Vertical; MPN JST B2B-XH-A
L1: 22uH; L_Bourns_SRN6045TA; MPN Bourns SRN6045TA-220M
Q1: AO3400A; SOT-23; MPN AOS AO3400A
Q2: BCP56-16; SOT-223-3_TabPin2; MPN Nexperia BCP56-16
R1, R11, R12, R13, R14, R15, R16, R36: 100k; R_0603_1608Metric; MPN 0603 100k 1%
R2: 54.9k; R_0603_1608Metric; MPN 0603 54.9k 1%
R3, R21, R22, R23, R27, R30, R31, R33: 10k; R_0603_1608Metric; MPN 0603 10k 1%
R4: 2.2k; R_0603_1608Metric; MPN 0603 2.2k 1%
R5, R6, R7, R8, R9, R10: 220; R_0603_1608Metric; MPN 0603 220 1%
R17, R18: 4.7k; R_0603_1608Metric; MPN 0603 4.7k 1%
R19, R20: 33; R_0603_1608Metric; MPN 0603 33 1%
R24, R32: 47k; R_0603_1608Metric; MPN 0603 47k 1%
R25, R28, R34: 1k; R_0603_1608Metric; MPN 0603 1k 1%
R26: 68k; R_0603_1608Metric; MPN 0603 68k 1%
R29: 470; R_0603_1608Metric; MPN 0603 470 1%
R35: 100; R_0603_1608Metric; MPN 0603 100 1%
R37: 330; R_0603_1608Metric; MPN 0603 330 1%
TP1: +24V; TestPoint_Pad_D1.5mm
TP2: +5V; TestPoint_Pad_D1.5mm
TP3: +3V3; TestPoint_Pad_D1.5mm
TP4: GND; TestPoint_Pad_D1.5mm
U1: LMR16006XDDCR; SOT-23-6; MPN TI LMR16006XDDCR
U2: AP2112K-3.3; SOT-23-5; MPN Diodes AP2112K-3.3TRG1
U3: Teensy 4.1; Teensy4.1_Socket; MPN PJRC Teensy 4.1 + 2x 1x24 disi header

Connections:
+3V3: C8.1, C9.1, C10.1, D6.2 (K), J3.1, R17.1, R18.1, R23.1, TP3.1, U2.5 (VOUT)
+5V: BZ1.1 (+), C5.1, C6.1, C7.1, C12.1, D4.2 (A), D8.1 (K), J2.1, L1.2, R2.1, R4.1, TP2.1, U2.1 (VIN), U2.3 (EN)
+24V: C1.1, C2.1, C3.1, D1.1 (K), D2.1 (A1), J11.1, R1.1, R26.1, TP1.1, U1.5 (VIN)
BATT_DIV: C14.1, D7.1 (K), R26.2, R27.1, R28.1
BUCK_CB: C4.1, U1.1 (CB)
BUCK_FB: R2.2, R3.1, U1.3 (FB)
BUCK_SHDN: R1.2, U1.4 (~SHDN)
BUCK_SW: C4.2, D3.1 (K), L1.1, U1.6 (SW)
BUZ_N: BZ1.2 (-), D8.2 (A), Q1.3 (D)
COIL_N: D10.2 (A), D11.1 (K), J12.2, Q2.2 (C), Q2.4 (C)
DEPTH_RAW: J2.3, R21.1
ESC_PWM0: J5.3, R5.2, R11.1
ESC_PWM1: J6.3, R6.2, R12.1
ESC_PWM2: J7.3, R7.2, R13.1
ESC_PWM3: J8.3, R8.2, R14.1
ESC_PWM4: J9.3, R9.2, R15.1
ESC_PWM5: J10.3, R10.2, R16.1
GND: C1.2, C2.2, C3.2, C5.2, C6.2, C7.2, C8.2, C9.2, C10.2, C11.2, C12.2, C13.2, C14.2, D2.2 (A2), D3.2 (A), D5.1 (K), D6.1 (A), D7.2 (A), D9.1 (K), D12.2 (A), J1.2, J2.2, J3.2, J5.1, J6.1, J7.1, J8.1, J9.1, J10.1, Q1.2 (S), Q2.3 (E), R3.2, R11.2, R12.2, R13.2, R14.2, R15.2, R16.2, R22.2, R24.2, R27.2, R30.2, R33.2, R36.2, TP4.1, U1.2 (GND), U2.2 (GND), U3.1 (GND), U3.26 (GND), U3.39 (GND)
IMU_SCL: J3.3, R19.2
IMU_SDA: J3.4, R20.2
KILL_DIV: D12.1 (K), R32.2, R33.1, R34.1
KILL_RET: D10.1 (K), J11.2, J12.1, R31.1, R32.1
LEAK_NODE: C13.1, J4.2, R24.1, R25.1
LEAK_P: J4.1, R23.2
LED_ESC_A: D11.2 (A), R31.2
LED_PWR_A: D5.2 (A), R4.2
LED_STAT_A: D9.2 (A), R37.2
Q1_G: Q1.1 (G), R35.2, R36.1
Q2_B: Q2.1 (B), R29.2, R30.1
TEENSY_VIN: D4.1 (K), U3.25 (VIN)
T_BATT_ADC: R28.2, U3.36 (15/A1)
T_BUZZER: R35.1, U3.44 (37)
T_DEPTH_ADC: C11.1, D6.3 (COM), R21.2, R22.1, U3.35 (16/A2)
T_ESC_EN: R29.1, U3.43 (38)
T_KILL_SENSE: R34.2, U3.45 (36)
T_LEAK_ADC: R25.2, U3.37 (14/A0)
T_LED: R37.1, U3.13 (11)
T_PWM0: R5.1, U3.4 (2)
T_PWM1: R6.1, U3.5 (3)
T_PWM2: R7.1, U3.6 (4)
T_PWM3: R8.1, U3.7 (5)
T_PWM4: R9.1, U3.8 (6)
T_PWM5: R10.1, U3.9 (7)
T_SCL0: R17.2, R19.1, U3.32 (19/SCL0)
T_SDA0: R18.2, R20.1, U3.33 (18/SDA0)
VBAT_F: D1.2 (A), F1.2
VBAT_IN: F1.1, J1.1

Notes on the sheet:
Guc girisi ve koruma (6S Li-Po 22.2 V)
6S -> 5 V buck (LMR16006X, 700 kHz)
5 V -> 3.3 V LDO ve Teensy VIN izolasyonu
Su gecirmez manyetik kill-switch ve ESC guc kontaktoru
Teensy 4.1 (Gercek Zamanli I/O)
6x Itici ESC PWM cikislari (M0..M5)
IMU (AFE-I2C, I2C0 400 kHz)
Hidrostatik basinc sensoru (SEN0257 5V -> 3.3V ADC)
Tup ici su sizinti probu ve 6S batarya ADC bolucu
Akustik buzzer ve durum LED
Test noktalari ve montaj delikleri

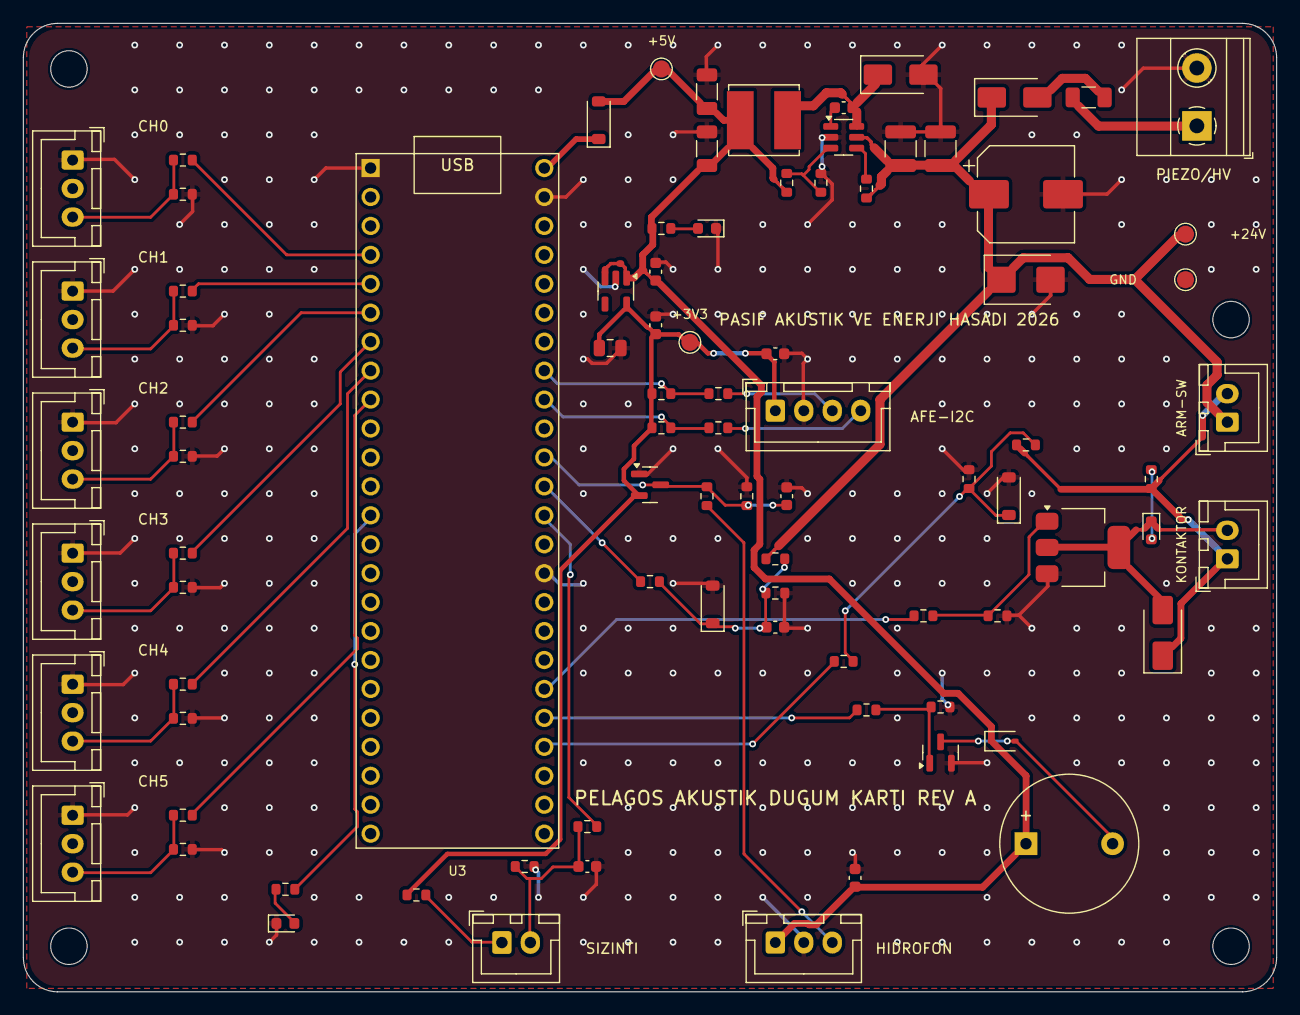
[picture p12: board pelagos-node-carrier.kicad_pcb from above]

Board: 2 copper layers, 110.0 x 85.0 mm, 91 parts (0 on the bottom side), 47 nets.
