eerdemgundogdu/acoustic-underwater-drone_swarm/(commit log)

2026-10-29 feat: add 2-layer hydrophone AFE & piezo harvesting PCB, LOFAR/DEMON FFT IFF & BFSK swarm mesh
    [pelagos-node-carrier-revA-bom.csv, pelagos-node-carrier.kicad_pcb, pelagos-node-carrier.kicad_sch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]
2026-10-29 ci(hardware): run kicad:9.0 container with --user root
2026-10-29 ci(hardware): align KiCad 9 ERC/DRC workflow with stingray-rov
2026-10-29 refactor: rename carrier project to acoustic-swarm-node and simplify docs
    [acoustic-swarm-node-revA-bom.csv, acoustic-swarm-node.kicad_pcb, acoustic-swarm-node.kicad_sch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]
2026-10-30 Rev A acoustic node board, 192 kHz DSP chain and authenticated BFSK mesh
    Hardware
    - New netlist: always-on wake-up chain (MCP6042 60 dB + TLV7031 gating
    the LMR16006X enable), dual-gain hydrophone AFE (MCP6022, 40 kHz
    Sallen-Key), discrete piezo harvester, DRV8871 BFSK driver, switched
    battery divider and reed arming switch
    - Board grows to 120x95 mm; Teensy pin map follows block placement
    - Router: same-numbered pads are one target, reverse search and
    corridor waypoints for board-length nets, GND stitching routed last
    - KiCad 9 support (kicad_env paths, multi-unit symbols, global labels);
    DRC 0 violations / 0 unconnected with schematic parity
    - 3D renders and layout view under har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
    [acoustic-swarm-node-revA-bom.csv, acoustic-swarm-node.kicad_pcb, acoustic-swarm-node.kicad_sch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]
